SEEKERSUNG/ESP32AirCheck/3Dmodel/preview_base_top.png

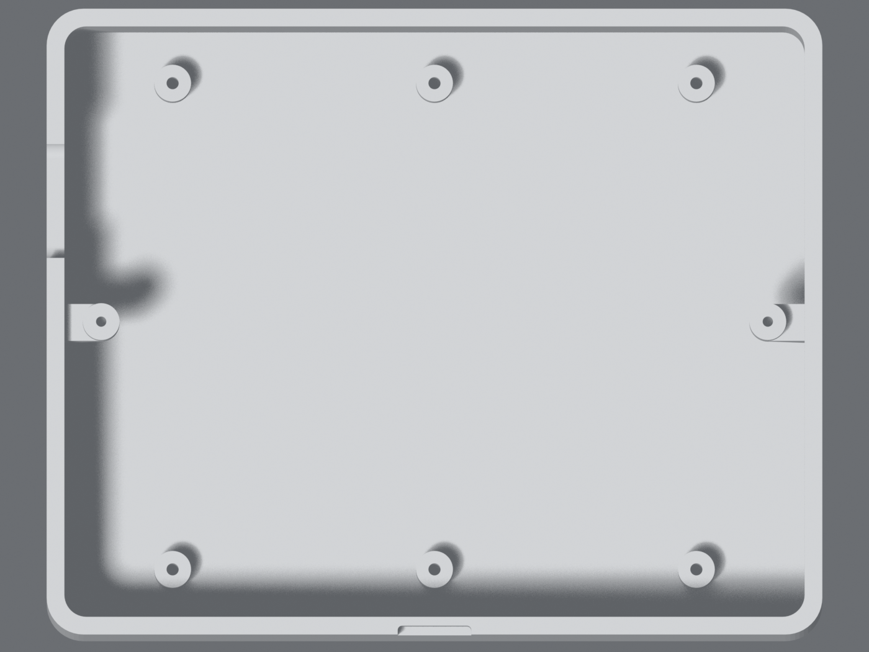
3Dmodel/preview_base_top.png
