SEEKERSUNG/ESP32AirCheck/3Dmodel/preview_exploded.png

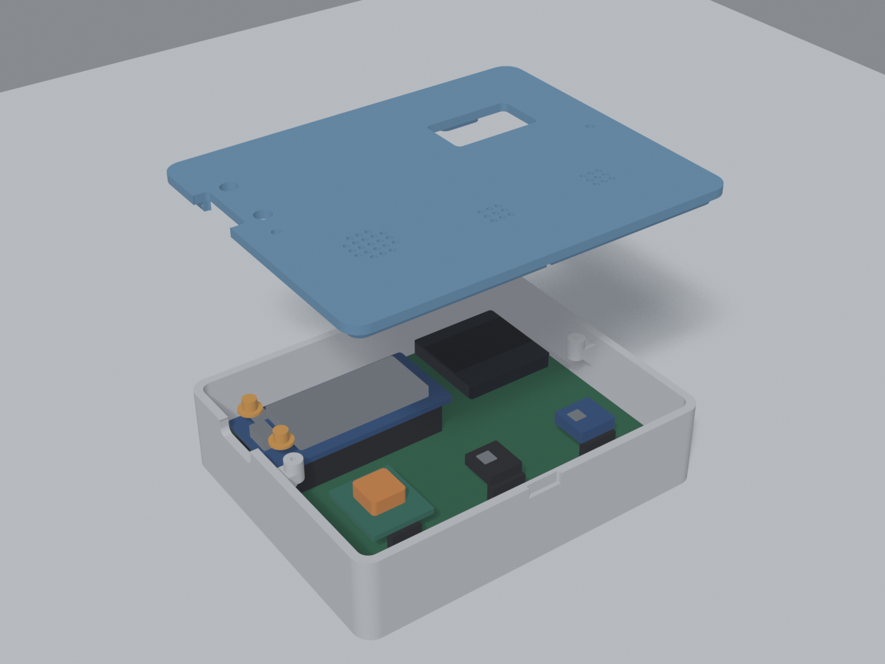
3Dmodel/preview_exploded.png
