SEEKERSUNG/ESP32AirCheck/3Dmodel/preview_lid_bottom.png

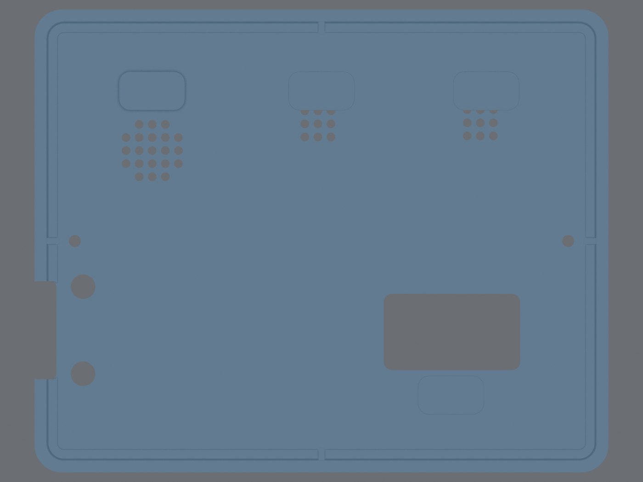
3Dmodel/preview_lid_bottom.png
