SEEKERSUNG/ESP32AirCheck/3Dmodel/preview_top.png

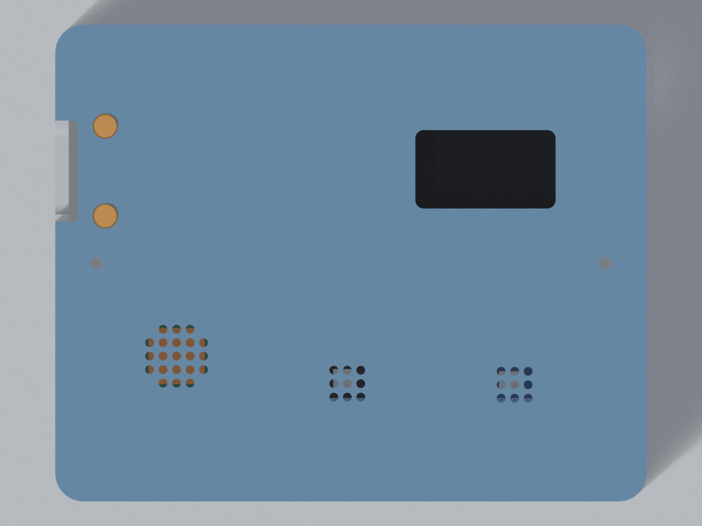
3Dmodel/preview_top.png
