SEEKERSUNG/ESP32AirCheck/tools/ui_layout.png

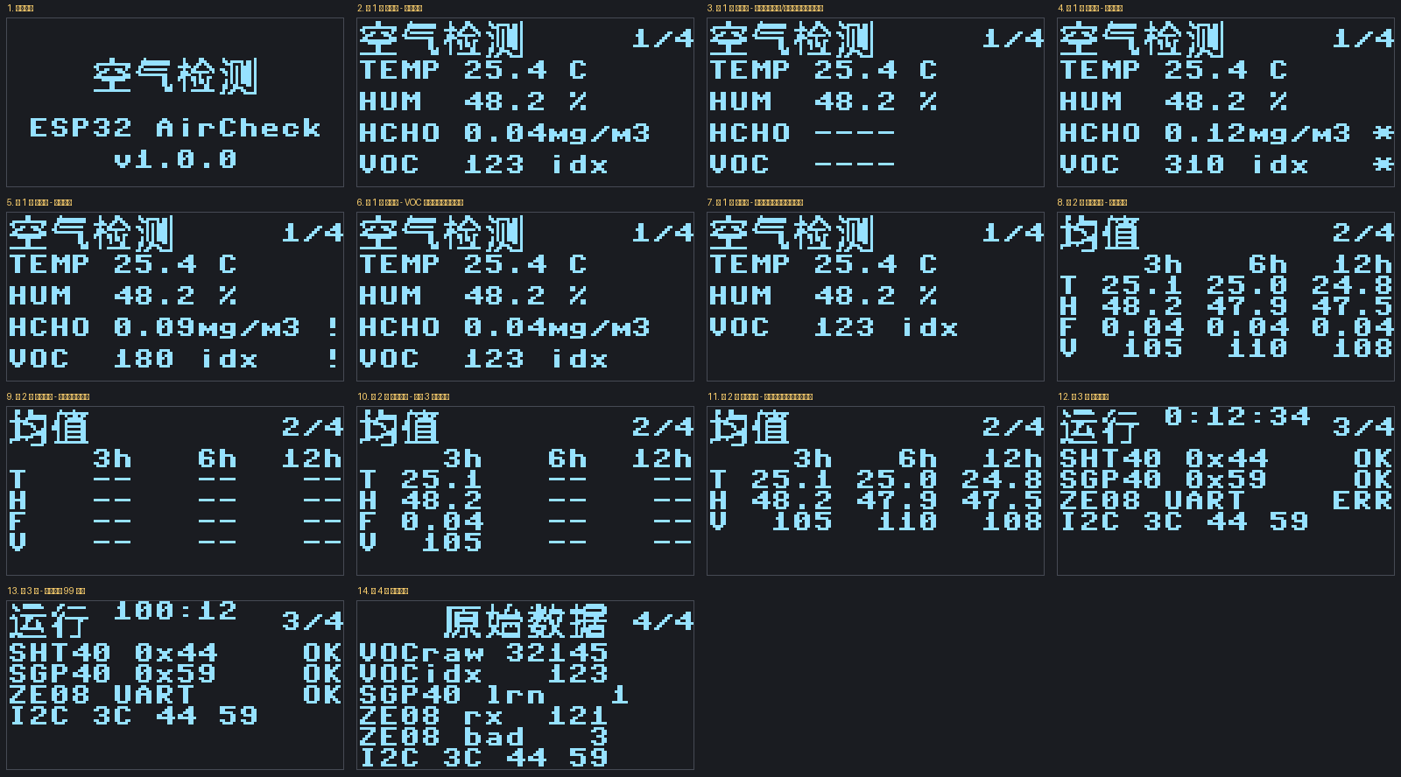
tools/ui_layout.png
