SEEKERSUNG/ESP32AirCheck/3Dmodel/ESP32AirCheck_enclosure_lid.stl

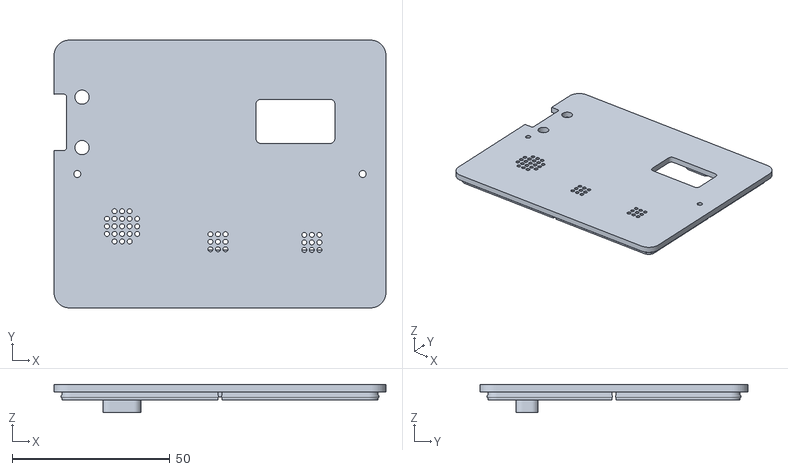
[picture p6: CAD file, 2026-11-01]
3Dmodel/ESP32AirCheck_enclosure_lid.stl
105.3 x 85.0 x 8.90
