SEEKERSUNG/ESP32AirCheck/PCB/ESP32AirCheckAllInOnePCB/3D_PCB1_2026-10-26.step

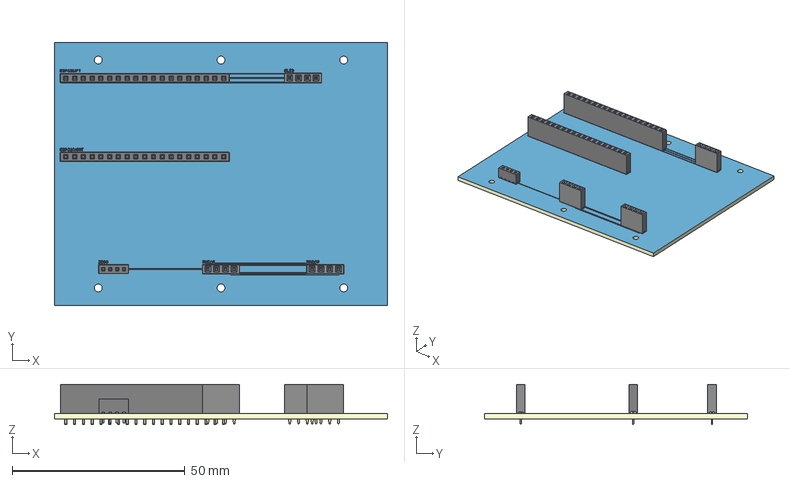
[picture p7: CAD file, 2026-11-01]
PCB/ESP32AirCheckAllInOnePCB/3D_PCB1_2026-10-26.step
96.5 x 76.2 x 11.7 mm
Board~Zxer
TopCopper~Zxer x 46
BottomCopper~Zxer x 46
TopSilkscreen~Zxer x 43
BottomSilkscreen~Zxer
TopFpcStiffener~Zxer
BottomFpcStiffener~Zxer
HDR-TH_4P-P2.00-V-F~HDR-TH_4P-P2.00-F-LI-1X4P~50VS
HDR-TH_4P-P2.54-V-F~HDR-TH_4P-P2.54-V-F~HYyp x 3
HDR-TH_19P-P2.54-V-F~HDR-TH_19P-P2.54-F-LI-1X19P~odMT x 2
