SEEKERSUNG/ESP32AirCheck/3Dmodel/ESP32AirCheck.3mf

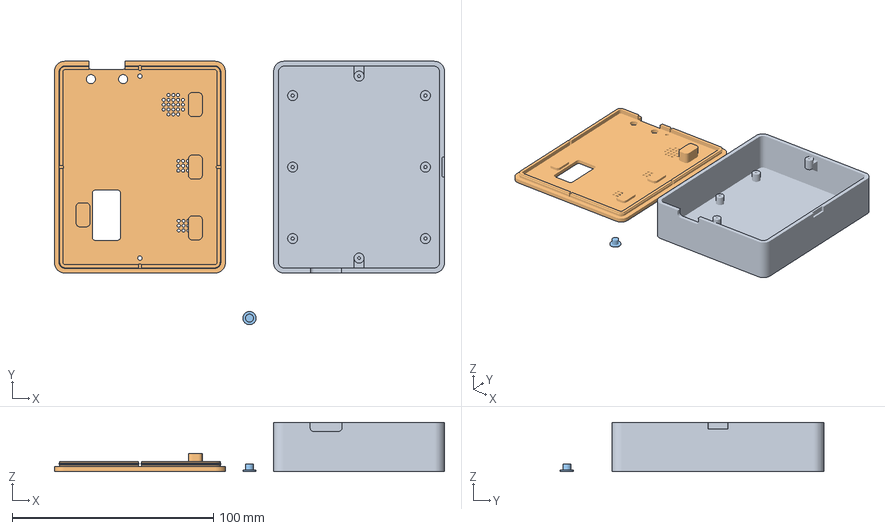
[picture p8: CAD file, 2026-11-01]
3Dmodel/ESP32AirCheck.3mf
194.0 x 131.1 x 24.4 mm
ESP32AirCheck_enclosure_base.stl
ESP32AirCheck_enclosure_lid.stl
ESP32AirCheck_button.stl
