SEEKERSUNG/ESP32AirCheck/3Dmodel/ESP32AirCheck_enclosure_base.stl

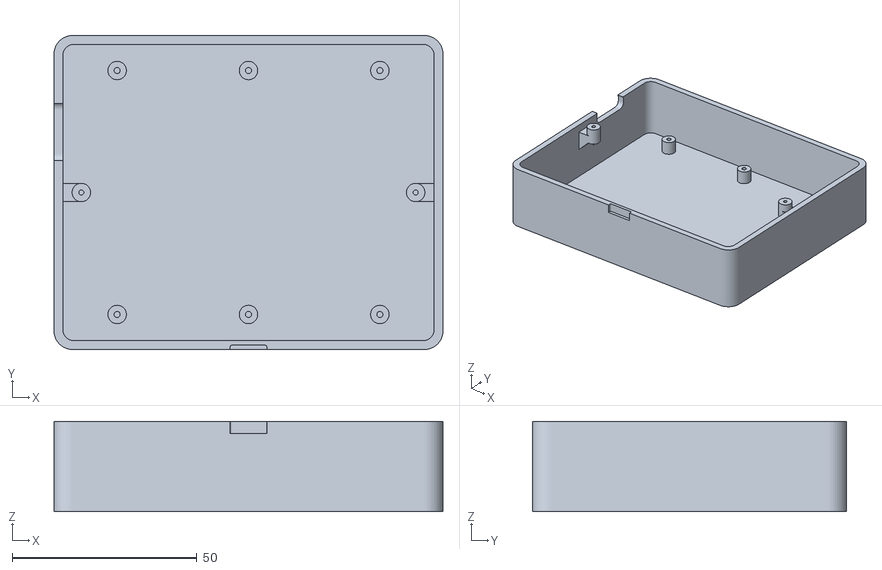
[picture p9: CAD file, 2026-11-01]
3Dmodel/ESP32AirCheck_enclosure_base.stl
105.3 x 85.0 x 24.4
