SEEKERSUNG/ESP32AirCheck/3Dmodel/ESP32AirCheck_button.stl

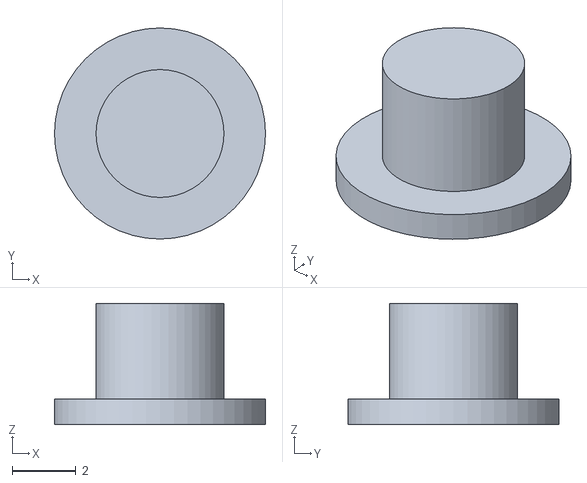
[picture p10: CAD file, 2026-11-01]
3Dmodel/ESP32AirCheck_button.stl
6.60 x 6.60 x 3.80
