SEEKERSUNG/ESP32AirCheck/(list of files, cad)

Other CAD files:
3Dmodel/ESP32AirCheck_enclosure.blend
3Dmodel/ESP32AirCheck_preview.blend
