SEEKERSUNG/ESP32AirCheck/3Dmodel/preview_assembly.png

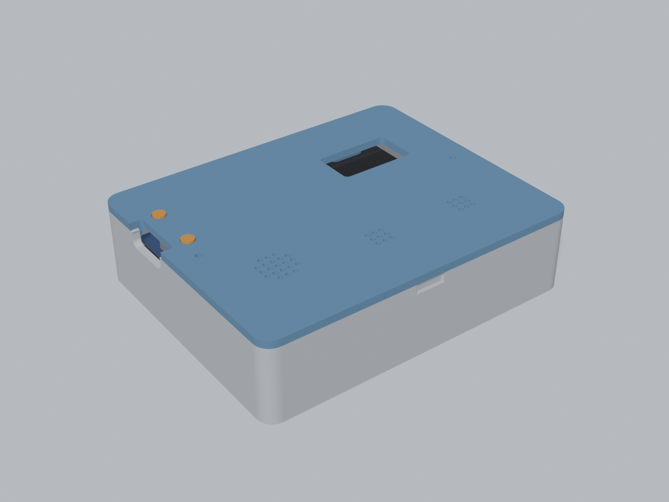
3Dmodel/preview_assembly.png
