SEEKERSUNG/ESP32AirCheck/src/config.py

# -*- coding: utf-8 -*-
"""
ESP32 空气质量检测仪 —— 全局配置
================================================================
所有需要按自己的硬件修改的内容都集中在本文件, 其它文件一般不用改。

硬件清单
    MCU      : ESP32 经典款 (ESP32-WROOM-32 / ESP32 DevKitC)
    显示屏   : 1.2 寸 OLED, 128x64, I2C (SSD1306 或 SH1106)
    温湿度   : SHT40   (I2C, 地址 0x44)
    TVOC     : SGP40   (I2C, 地址 0x59)
    甲醛     : ZE08-CH2O (UART, 9600 8N1)

接线请看项目根目录 README.md 的“接线表”。
"""

VERSION = "1.0.0"
BOARD = "ESP32-GENERIC"

# --------------------------------------------------------------------------
# 1. 调试
# --------------------------------------------------------------------------
# True  : 通过 USB 串口(REPL) 打印运行日志, 便于排查问题
# False : 安静模式, 只驱动屏幕
DEBUG = True
# 打印 I2C 扫描结果
DEBUG_SCAN = True

# --------------------------------------------------------------------------
# 2. I2C 总线
#     OLED / SHT40 / SGP40 三者共用一条 I2C 总线
#     它们的地址互不冲突, 可以并联在同一组 SDA/SCL 上
# --------------------------------------------------------------------------
I2C_ID = 0
# 本板子的排针没有引出 GPIO21, 所以 I2C 改用 GPIO32/33。
# 这两个脚不与本项目其它外设(GPIO0/2/16/17/25)冲突。
I2C_SDA = 32            # GPIO32 -> 所有 I2C 模块的 SDA
I2C_SCL = 33            # GPIO33 -> 所有 I2C 模块的 SCL
I2C_FREQ = 400000       # 400kHz 快速模式

# --------------------------------------------------------------------------
# 3. OLED 显示屏
# --------------------------------------------------------------------------
OLED_ENABLED = True

# 控制器型号:
#   "ssd1306" —— 绝大多数 0.96 寸 / 1.2 寸 128x64 模块
#   "sh1106"  —— 部分 1.3 寸 / 早期 1.2 寸 128x64 模块
# 如果屏幕点不亮, 或者整幅图像向右错位 2 个像素, 就把这里改成 "sh1106"。
# 也可以用工具脚本在线判断: python tools/deploy.py run test_oled
OLED_CONTROLLER = "ssd1306"

OLED_WIDTH = 128
OLED_HEIGHT = 64
OLED_ADDR = 0x3C        # 极少数模块是 0x3D
OLED_CONTRAST = 0xFF    # 0~255 亮度
OLED_ROTATE = False     # True 表示 180° 翻转

# 屏幕刷新周期 (毫秒)
UI_PERIOD_MS = 250

# 无操作自动息屏:
# 超过该时间没有按键操作就关闭 OLED 显示; 按 BOOT 键 (GPIO0) 唤醒。
# 唤醒的那次按键只亮屏, 不翻页; 再按才切换页面。
# 设为 0 表示关闭息屏功能。
SCREEN_OFF_MS = 10 * 1000

# --------------------------------------------------------------------------
# 4. I2C 传感器地址
# --------------------------------------------------------------------------
SHT40_ADDR = 0x44       # SHT40 默认地址, ADDR 引脚拉高则为 0x45
SGP40_ADDR = 0x59       # SGP40 固定地址

# 各传感器是否启用 (单独测试某个传感器时可以只留一个 True)
SHT40_ENABLED = True
SGP40_ENABLED = True

# --------------------------------------------------------------------------
# 5. ZE08-CH2O 甲醛传感器 (UART)
# --------------------------------------------------------------------------
ZE08_ENABLED = True
ZE08_UART_ID = 2
ZE08_TX = 17            # ESP32 的 TX (GPIO17) -> ZE08 的 RXD
ZE08_RX = 16            # ESP32 的 RX (GPIO16) <- ZE08 的 TXD
ZE08_BAUD = 9600        # 出厂固定 9600 8N1

# --------------------------------------------------------------------------
# 6. 指示灯 / 按键 / 蜂鸣器 (不需要可以关掉)
# --------------------------------------------------------------------------
STATUS_LED = 2                  # 板载蓝色 LED (ESP32 DevKitC); 无则填 None
STATUS_LED_ACTIVE_LOW = False   # 板载 LED 低电平点亮时改 True

BUTTON_ENABLED = True           # 接一个按键到 GND, 用于翻页/消音
# GPIO0 就是开发板上标着 BOOT 的那个按键, 不用额外接线。
# 注意: GPIO0 是启动模式选择脚, 上电/复位那一刻不能按住,
#       否则 ESP32 会进下载模式而不是运行程序。
BUTTON_PIN = 0                  # 内部上拉, 按下为低电平
# 长按 BOOT 键多久触发“重新学习 VOC 基线”(毫秒)
# 短按仍然是翻页/唤醒; 设为 0 关闭长按功能
VOC_RESET_HOLD_MS = 3000

BUZZER_ENABLED = False          # 有源蜂鸣器, 报警时鸣叫
BUZZER_PIN = 25


# --------------------------------------------------------------------------
# 7. 上电预热时间 (秒)
# --------------------------------------------------------------------------
# 预热的含义: 传感器已连上、也在正常通信, 但读数还没到可信状态。
# 预热期间屏幕上会显示专门的“预热中”标记和倒计时。
#
# 依据 (详见 README.md 的说明):
#   SHT40   几乎不需要预热, 上电后第一次测量即可用
#   ZE08    数据手册标明 预热时间 <= 3 分钟
#   SGP40   算法前 45s 为 blackout, 约 1 小时才完全收敛到最佳状态
#           这里取 60s 作为“可读数”的门限, 1 小时内屏幕右上角仍会显示
#           “学习”标记 (~), 表示 VOC 指数还在自我学习基线
WARMUP_SHT40 = 1
WARMUP_ZE08 = 180
WARMUP_SGP40 = 60

# SGP40 VOC 算法的完整学习时间(秒), 仅用于在屏幕上显示“学习期”标记
VOC_LEARN_S = 3600

# VOC 基线跨断电保存:
# 算法状态写入 ESP32 的 NVS (不是 SGP40 —— 传感器内部没有基线存储)。
# 上电时如果找到有效状态就恢复, 避免重新学习; 运行中每 10 分钟保存一次。
# 想彻底重新学习: 在 REPL 里执行
#     import sensors; sensors._erase_state()
# 然后复位/重启。只把 VOC_STATE_PERSIST 改成 False 只是本次不读不写,
# 旧状态还在。
VOC_STATE_PERSIST = True
VOC_STATE_SAVE_MS = 10 * 60 * 1000      # 10 分钟

# --------------------------------------------------------------------------
# 8. 历史均值 (第 2 页: 近 3 / 6 / 12 小时平均值)
# --------------------------------------------------------------------------
# 传感器是 1Hz 采样, 直接把 12 小时的原始点全存下来要几百 KB, 放不下。
# 这里每 HISTORY_BUCKET_MS 把这段时间内的采样压成一个"桶"的平均值,
# HISTORY_SLOTS 个桶围成一个环:
#   3h = 36 桶, 6h = 72 桶, 12h = 144 桶(5 分钟一个桶时刚好都是整数)
# 桶内平均对每个采样点等权, 所以结果和直接对原始点求平均一致。
# 屏幕上的均值每 5 分钟才更新一次, 这是刻意的: 均值是慢变量。
HISTORY_BUCKET_MS = 5 * 60 * 1000       # 5 分钟一个桶
HISTORY_SLOTS = 144                     # 144 桶 = 12 小时

# 跨断电保留 (写入 ESP32 NVS, 约 1.2KB)。
# 注意板子没有 RTC, 无法知道断电了多久, 恢复时按"一直在线"处理。
HISTORY_PERSIST = True
HISTORY_SAVE_MS = 10 * 60 * 1000        # 10 分钟存一次

# --------------------------------------------------------------------------
# 9. 报警阈值
# --------------------------------------------------------------------------
# WARN  = 警告级: 主界面数值旁显示常亮 !, LED/蜂鸣器不动作
# ALARM = 报警级: 主界面闪烁 *, 板载 LED 快闪, (若启用)蜂鸣器鸣叫
#
# 甲醛: 0.08 参考 GB/T 18883-2022 (1小时均值), 0.10 为项目报警线。
# 代码比较的是瞬时值, 不是 1 小时滑动平均。
HCHO_WARN = 0.08        # mg/m3
HCHO_ALARM = 0.10       # mg/m3

# VOC 指数 (Sensirion 定义): 100 为基线, 越大空气越差
# 注意这是指数, 不是浓度; 界面标签为 VOC
TVOC_WARN = 150
TVOC_ALARM = 250

# --------------------------------------------------------------------------
# 10. 采样 / 轮询周期
# --------------------------------------------------------------------------
# I2C 传感器的主轮询周期 (毫秒)
I2C_POLL_MS = 1000
# 断开/未连接传感器的重新探测周期 (毫秒) —— 支持运行中热插拔传感器
RESCAN_MS = 10000

# LED / 蜂鸣器
LED_HEARTBEAT_MS = 2000

# --------------------------------------------------------------------------
# 11. Wi-Fi / Home Assistant MQTT (可选)
# --------------------------------------------------------------------------
# 真实凭据放在 src/secrets.py (已被 .gitignore 忽略), 不要写进本文件。
# 留空则完全不启用网络, 不影响本地采集和屏幕。
try:
    from secrets import (WIFI_SSID, WIFI_PASSWORD, MQTT_HOST, MQTT_PORT,
                         MQTT_USER, MQTT_PASSWORD)
except ImportError:
    WIFI_SSID = ""
    WIFI_PASSWORD = ""
    MQTT_HOST = ""
    MQTT_PORT = 1883
    MQTT_USER = ""
    MQTT_PASSWORD = ""

MQTT_BASE = "esp32aircheck"     # 主题前缀, 后面会拼设备 MAC
MQTT_PUBLISH_MS = 10000         # 状态发布周期 (毫秒)
MQTT_KEEPALIVE = 60
HA_DISCOVERY = True             # 自动发布 Home Assistant MQTT Discovery
HA_DISCOVERY_PREFIX = "homeassistant"
DEVICE_NAME = "ESP32 AirCheck"
