SEEKERSUNG/ESP32AirCheck/src/cfont.py

# -*- coding: utf-8 -*-
# 本文件由 tools/gen_font.py 自动生成, 请勿手工修改。
# 字体来源: msyh.ttc
# 每个汉字 16x16, 32 字节, LSB-first (bit0 = 最左像素)
# 具体用哪个 framebuf 格式由 ui.py 运行时探测(MONO_GLYPH)。

GLYPH_W = 16
GLYPH_H = 16

GLYPHS = {
    0x4e2d:  # 中
    b'\x00\x00\x80\x00\x80\x00\x80\x00\xfe\x3f\xfe\x3f\x82\x20\x86\x20\x86\x30\xfe\x3f\x86\x30\x80\x00\x80\x00\x80\x00\x80\x00\x00\x00',
    0x4e60:  # 习
    b'\x00\x00\xfe\x7f\xe4\x6f\x00\x60\x38\x60\xe0\x60\x80\x61\x00\x60\x00\x6e\xc0\x67\xf8\x60\x1e\x60\x00\x60\x00\x3f\x00\x1f\x00\x00',
    0x4f20:  # 传
    b'\x00\x00\x10\x03\x18\x03\xd8\x3f\x08\x01\x8c\x01\xec\x7f\x8e\x00\xca\x3f\x08\x3f\xc8\x18\x88\x0d\x08\x07\x08\x0c\x00\x00\x00\x00',
    0x4fe1:  # 信
    b'\x00\x00\x10\x02\x18\x06\xf8\x7f\x08\x00\xcc\x3f\x0c\x00\xce\x3f\x08\x00\xc8\x3f\xc8\x3f\x48\x20\xc8\x3f\xc8\x3f\x00\x00\x00\x00',
    0x5019:  # 候
    b'\x00\x00\x98\x1f\x98\x1f\x28\x10\xec\x7f\xac\x01\x2e\x3b\xae\x3f\xa8\x04\xe8\x7f\xa8\x7f\x28\x0e\x88\x1b\xc8\x71\x00\x00\x00\x00',
    0x503c:  # 值
    b'\x00\x00\x10\x02\xf8\x7f\x48\x36\x88\x1f\xcc\x3f\x4c\x30\xce\x3f\x4e\x30\xc8\x3f\x48\x30\xc8\x3f\x48\x30\xfc\x7f\x00\x00\x00\x00',
    0x5168:  # 全
    b'\x00\x00\x80\x01\xc0\x03\x60\x06\x30\x0c\x1c\x38\xfe\x7f\xf0\x0f\x80\x01\xf8\x1f\xf8\x1f\x80\x01\x80\x01\xfc\x7f\x00\x00\x00\x00',
    0x539f:  # 原
    b'\x00\x00\x00\x00\xfc\x7f\x0c\x01\xec\x3f\x6c\x30\xec\x3f\xec\x3f\x6c\x30\xec\x3f\x4c\x0a\x6c\x1a\x36\x72\x96\x63\x00\x00\x00\x00',
    0x5668:  # 器
    b'\x00\x00\x00\x00\x7c\x3e\x44\x33\x7c\x3e\x7c\x3f\x80\x0d\xfe\x7f\x60\x06\x3e\x7c\x7c\x3e\x44\x32\x7c\x3e\x7c\x3e\x00\x00\x00\x00',
    0x5747:  # 均
    b'\x00\x00\x18\x03\x18\x03\x08\x7f\x98\x7f\xfe\x40\xd8\x43\x18\x46\x18\x64\x18\x78\x18\x7e\xf8\x63\x9e\x60\x02\x60\x00\x3e\x00\x00',
    0x59cb:  # 始
    b'\x00\x00\x08\x06\x08\x02\x08\x13\x3e\x31\xec\x3f\xec\x7f\x24\x40\xa4\x3f\xbc\x35\x98\x20\xb8\x20\xec\x3f\x86\x3f\x00\x00\x00\x00',
    0x5b66:  # 学
    b'\x00\x00\x88\x10\x98\x19\x10\x09\xfc\x3f\xfe\x7f\x06\x60\xf0\x0f\x00\x0e\x00\x03\xfe\x7f\xfe\x7f\x00\x01\x80\x01\xe0\x01\x00\x00',
    0x5c31:  # 就
    b'\x00\x00\x10\x06\x30\x1e\xfe\x36\x00\x06\xfc\x7f\xfc\x3f\xc4\x0e\xfc\x0e\xfc\x0a\x74\x0a\xd4\x4b\x96\x49\xb2\x69\xdc\x78\x00\x00',
    0x5e38:  # 常
    b'\x00\x00\x88\x31\x98\x19\xfe\x7f\xfe\x7f\xf2\x4f\xf8\x1f\x18\x18\xf8\x1f\x80\x01\xfc\x3f\x8c\x21\x84\x21\x84\x3d\x84\x19\x00\x00',
    0x5ea6:  # 度
    b'\x00\x00\x00\x01\xf8\x7f\xfc\x7f\x4c\x08\xfc\x7f\x4c\x08\xcc\x0f\x4c\x08\xfc\x1f\xcc\x18\x8c\x0f\x84\x07\xf6\x7c\x00\x00\x00\x00',
    0x5f02:  # 异
    b'\x00\x00\xfc\x1f\x0c\x18\x0c\x18\xfc\x5f\x0c\x60\xf8\x7f\xf8\x3f\x20\x0c\x30\x0c\xfe\x7f\x30\x0c\x18\x0c\x0c\x0c\x00\x00\x00\x00',
    0x606f:  # 息
    b'\x00\x00\xc0\x00\xf8\x1f\x18\x18\xf8\x1f\xf8\x1f\xf8\x1f\xd8\x1b\xf8\x1f\xf8\x1f\x94\x31\x34\x69\x36\x4c\xf2\x07\x00\x00\x00\x00',
    0x611f:  # 感
    b'\x00\x00\x00\x16\xf0\x3f\xfc\x7f\xec\x07\xfc\x35\xec\x1d\xb4\x4d\xf4\x6d\xf6\x3e\x86\x01\x3c\x3d\x36\x6c\xe2\x47\x00\x00\x00\x00',
    0x636e:  # 据
    b'\x00\x00\x88\x3f\xc8\x7f\x7e\x60\xfe\x7f\xc8\x3f\x48\x0c\xf8\x7f\x5e\x04\x48\x3f\xe8\x3f\xe8\x21\xa8\x3f\xbe\x3f\x00\x00\x00\x00',
    0x63a5:  # 接
    b'\x00\x00\x08\x06\xc8\x3f\xdc\x7f\xbe\x11\x08\x19\xe8\x7f\x18\x02\xfe\x7f\xc8\x7f\x88\x19\x08\x0f\x08\x1f\xee\x71\x00\x00\x00\x00',
    0x6570:  # 数
    b'\x00\x00\x30\x04\xb4\x04\xf0\x3e\xfe\x7e\x78\x23\xfc\x33\xb6\x36\x18\x16\xfe\x1c\xcc\x0c\x7c\x1c\x70\x36\xde\x63\x00\x00\x00\x00',
    0x65f6:  # 时
    b'\x00\x00\x00\x18\x3e\x18\x3e\x10\xe2\x7f\xa2\x7f\x22\x10\xbe\x19\x36\x19\x22\x1b\x22\x1a\x22\x18\x3e\x10\x26\x18\x22\x1f\x00\x00',
    0x672a:  # 未
    b'\x00\x00\x80\x01\x80\x01\xfc\x3f\xfc\x3f\x80\x01\x80\x01\xfe\x7f\xc0\x03\xe0\x07\xb0\x0d\x98\x39\x8e\x71\x80\x01\x00\x00\x00\x00',
    0x672c:  # 本
    b'\x00\x00\x80\x01\x80\x01\xfe\x7f\xfc\x7f\xc0\x03\xe0\x07\xa0\x05\xb0\x0d\x98\x19\xac\x75\xf6\x6f\x80\x01\x80\x01\x00\x00\x00\x00',
    0x6807:  # 标
    b'\x00\x00\x08\x00\x88\x3f\x3e\x00\x3e\x00\x08\x00\xdc\x7f\x3c\x04\x8e\x14\x8a\x34\xc8\x24\x68\x64\x68\x64\x88\x07\x00\x00\x00\x00',
    0x68c0:  # 检
    b'\x00\x00\x08\x06\x08\x0e\x18\x1b\xbe\x31\xc8\x60\xdc\x5f\x3c\x02\xce\x32\xca\x16\x88\x16\x88\x18\x08\x18\xc8\x7f\x00\x00\x00\x00',
    0x6c14:  # 气
    b'\x00\x00\x10\x00\xf8\x3f\xf8\x3f\x0c\x00\xf4\x1f\x06\x00\xfc\x1f\x00\x18\x00\x18\x00\x18\x00\x58\x00\x70\x00\x70\x00\x00\x00\x00',
    0x6d4b:  # 测
    b'\x00\x00\x04\x40\xec\x5b\x38\x5a\xa0\x5e\xa6\x5e\xac\x5e\xa8\x5e\xa0\x5e\xa8\x5e\xa8\x5e\xcc\x58\xcc\x43\x64\x46\x36\x7c\x00\x00',
    0x6e29:  # 温
    b'\x00\x00\xc4\x1f\xcc\x3f\x48\x30\xc0\x3f\x46\x30\xcc\x3f\x40\x00\xe0\x3f\xec\x3f\x2c\x25\x2c\x25\xe4\x3d\xf6\x7f\x00\x00\x00\x00',
    0x6e7f:  # 湿
    b'\x00\x00\xc4\x3f\xec\x3f\x48\x30\xe0\x3f\x66\x20\xec\x3f\x40\x2d\x20\x4d\x6c\x6d\xec\x3d\xcc\x1d\x84\x0d\xf6\x7f\x00\x00\x00\x00',
    0x70ed:  # 热
    b'\x00\x00\x08\x03\x08\x03\xfe\x1f\x18\x1b\x18\x19\xfc\x19\x9e\x5b\x88\x5f\xc8\x70\x6e\x70\x00\x10\x2c\x32\x64\x26\x46\x66\x00\x00',
    0x7248:  # 版
    b'\x00\x00\x34\x38\xb4\x3f\xb4\x00\xb4\x00\xfc\x3f\x84\x23\x84\x22\xbc\x36\xb4\x14\xb4\x1c\xb4\x0c\xf6\x3e\xf6\x63\x00\x00\x00\x00',
    0x7532:  # 甲
    b'\x00\x00\xfe\x3f\x86\x30\x82\x20\x86\x30\xfe\x3f\x86\x30\x82\x20\x86\x30\xfe\x3f\xc6\x31\x80\x00\x80\x00\x80\x00\x80\x00\x00\x00',
    0x79d2:  # 秒
    b'\x00\x00\x30\x04\x3e\x04\x18\x15\x98\x35\xbe\x65\x98\x44\xdc\x04\x7c\x24\x1e\x34\x1a\x18\x1a\x0e\x98\x03\xd8\x01\x00\x00\x00\x00',
    0x7a0d:  # 稍
    b'\x00\x00\x80\x04\xfe\x64\x98\x35\x18\x1d\xfe\x7f\xd8\x60\x98\x7f\xbc\x7f\xfc\x60\x9e\x7f\x9a\x7e\x98\x60\x98\x3c\x00\x00\x00\x00',
    0x7a7a:  # 空
    b'\x00\x00\x80\x01\x80\x01\xfc\x7f\x06\x60\x64\x2e\x38\x1c\x0c\x70\xfe\x7f\xf0\x1f\x80\x01\x80\x01\x80\x01\xfe\x7f\x00\x00\x00\x00',
    0x7eea:  # 绪
    b'\x00\x00\x18\x02\x08\x22\x8c\x3f\x24\x12\x36\x1a\xde\x7f\x08\x06\x0c\x3f\xfe\x3f\xfe\x21\x80\x3f\xb8\x31\xbe\x3f\x80\x3f\x00\x00',
    0x81ea:  # 自
    b'\x00\x00\xc0\x00\xc0\x00\xfc\x3f\x0c\x30\x04\x20\xfc\x3f\xfc\x3f\x04\x20\x0c\x30\xfc\x3f\x0c\x30\x04\x20\xfc\x3f\xfc\x3f\x00\x00',
    0x884c:  # 行
    b'\x00\x00\x30\x00\x98\x3f\x08\x00\x26\x00\x36\x00\xd8\x7f\x18\x18\x1c\x08\x1e\x08\x18\x08\x18\x08\x18\x08\x18\x0f\x00\x00\x00\x00',
    0x8bf7:  # 请
    b'\x00\x00\x00\x06\xec\x7f\x58\x06\xc0\x3f\x00\x06\xee\x7f\x8c\x1d\xc8\x3f\x48\x30\xc8\x3f\xc8\x30\xf8\x3f\x5c\x30\x4c\x3c\x00\x00',
    0x8d85:  # 超
    b'\x00\x00\x10\x3f\x90\x3f\x7e\x22\x10\x22\x10\x3f\xfe\x01\x30\x3f\x34\x33\x74\x21\x34\x3f\x3e\x3f\x3e\x01\xf2\x7f\x00\x00\x00\x00',
    0x8fd0:  # 运
    b'\x00\x00\xc4\x1f\xcc\x3f\x18\x00\x00\x00\xe4\x7f\x8e\x03\x88\x09\x88\x18\xc8\x18\xe8\x3f\x08\x20\x3e\x00\xf6\x7f\x00\x00\x00\x00',
    0x8fde:  # 连
    b'\x00\x00\x04\x01\x8c\x07\xf8\x7f\x80\x04\xc0\x06\xce\x06\xc8\x3f\x08\x04\xe8\x7f\xe8\x7f\x0c\x06\x1e\x04\xf6\x7f\x00\x00\x00\x00',
    0x90e8:  # 部
    b'\x00\x00\x30\x00\x30\x7e\xfe\x67\x8c\x26\xc8\x36\x78\x16\xfe\x37\x00\x66\xfc\x66\xfc\x46\x84\x46\x84\x7e\xfc\x16\xfc\x06\x00\x00',
    0x919b:  # 醛
    b'\x00\x00\x7e\x32\xfe\x7f\x38\x3f\x7e\x0c\x7e\x1e\xfe\x33\xfe\x7f\x66\x0c\x46\x0c\x7e\x3f\x42\x0c\x7e\x0c\xfe\x7f\x00\x00\x00\x00',
    0x95f4:  # 间
    b'\x00\x00\x04\x00\xcc\x3f\x18\x20\x02\x20\xf2\x27\x32\x26\x32\x26\xf2\x27\x32\x26\x32\x26\xf2\x27\xf2\x21\x02\x20\x02\x3c\x00\x00',
    0x9875:  # 页
    b'\x00\x00\xfe\x7f\x80\x01\x80\x01\xf8\x3f\x08\x30\x88\x31\x88\x31\x88\x31\x88\x31\x88\x33\xc0\x0f\x70\x3c\x3e\x70\x00\x00\x00\x00',
    0x9884:  # 预
    b'\x00\x00\xfe\x7f\x30\x04\x1c\x04\x98\x3f\xbe\x25\xfe\x2d\xe8\x2d\xb8\x2d\x98\x25\x98\x25\x18\x0e\x18\x3b\xce\x61\x00\x00\x00\x00',
}
