SEEKERSUNG/ESP32AirCheck/(commit log)

2026-10-17 新增 ESP32 空气质量检测仪 (SHT40/SGP40/SCD40/ZE08 + OLED)
    硬件: ESP32 经典款 + 1.2 寸 OLED(128x64) + SHT40 温湿度 + SGP40 TVOC + SCD40 CO2 + ZE08-CH2O 甲醛
    - src/ asyncio 主程序、四路传感器驱动、Sensirion VOC 指数算法移植、16x16 中文字库、SSD1306/SH1106 驱动
    - 上电逐个自检 + 预热倒计时标记 + 热插拔定时重探测 + I2C 总线卡死自恢复
    - tools/ 部署脚本、字库生成、界面排版预览、板上测试、主机回归测试
    - README 接线表(I2C=GPIO32/33, ZE08=GPIO16/17)、报警阈值、常见问题、开发笔记
    - .gitignore 忽略 __pycache__
    [boot.py, cfont.py, config.py, main.py, sensors.py]
2026-10-20 移除 CO2/SCD40 支持, 直接进主界面, 按键改 GPIO0
    - 彻底移除 SCD40 二氧化碳支持: 删 src/scd40.py 和 tools/tests/test_scd40.py,
    以及 config 里的 SCD40_ADDR/SCD40_ENABLED/WARMUP_SCD40/CO2_WARN/CO2_ALARM/
    SCD40_EVERY, 状态机里的 scd40 通道与 co2 字段, 界面里的 CO2 行和第 4 个状态灯
    - 删除开机自检页: 上电直接进主界面, 未连接/异常的传感器在状态栏内联提示,
    其余传感器照常显示数值
    - 修复三处只在真机上才暴露的 bug:
    * I2C 通道初值 ST_PROBE 不在探测分支里, 导致永远不探测
    * any_alarm() 依赖 snapshot() 求值, 没有屏幕时报警不生效
    * learning 对所有通道为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
    [cfont.py, config.py, framebuf.py, machine.py, main.py, sensors.py]
2026-10-20 更新文档: 与移除 CO2 后的实际代码对齐
    - 第 3 页示例里的 I2C 扫描结果去掉 0x62
    - 开机画面时长改成实测的 1.2 秒 (原写 2 秒)
    - 主界面说明补上"关闭的传感器整行不画、剩余行自动上收"
    - 5.5 说明字库是按 gen_font.py 顶部的 CHARS 生成的, 缺字会画空心方框
    - 5.4 补充 run_board_test.py 的适用范围 (test_ui.py 必须上板跑)
    - 新增常见问题: 串口打不开的两种 PermissionError (被占用 vs CH340 卡死)
    - 新增开发笔记 10.9: 一个 enabled 有三个消费者, 必须同时判断
    - 10.2 行距说明按现在的三行数据 + 状态栏宽度限制重写
    - 10.6 的症状描述改成"状态栏停在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
2026-10-20 新增息屏与 VOC 基线持久化, 修复总线恢复等问题
    - 主界面只显示读数, 连接/预热状态统一看第 2 页
    - VOC 基线每 10 分钟存入 ESP32 NVS, 断电重启后恢复
    - 10 秒无操作自动熄屏, 按 BOOT 键唤醒且不翻页
    - 修复总线恢复失败后不再重试、SH1106 无法旋转等问题
    - 补充 NVS、息屏、排版回归测试并同步文档
    [config.py, main.py, sensors.py, sh1106.py, test_state_machine.py, test_ui.py]
2026-10-21 修正传感器换算与显示, 支持 ZE08 问答模式
    - ZE08 问答模式周期请求, 修复 5 秒后掉线
    - 统一 ze08.ugm3 单位为 ug/m3, 超量程限幅
    - HCHO 显示改为 2 位小数, 主界面标签改为 VOC
    - 启用警告阈值: 警告 ! / 报警 *; 修正 SGP40 软复位和 SHT40 加热器
    - 补充 ZE08 问答、单位、警告阈值回归测试并同步文档
    [config.py, sensors.py, sgp40.py, sht40.py, test_state_machine.py, test_ui.py, test_ze08_parse.py, ui.py]
2026-10-21 文档: 补充 ZE08 探测阶段问答命令重试说明
2026-10-24 新增长按 BOOT 重置 VOC 基线
    - 长按 BOOT 3 秒清除算法状态和 NVS 基线, 以当前环境重新学习
    - 短按改为松手触发, 长按释放不翻页
    - 补充长按/短按和重置逻辑回归测试, 更新文档
2026-10-24 新增 Home Assistant MQTT 接入
    - 新增 net.py: Wi-Fi/MQTT 重连、HA MQTT Discovery、状态和可用性发布
    - config/secrets.py 分离 Wi-Fi 与 MQTT 凭据, secrets.py 不入库
    - 新增 MQTT Discovery 回归测试和 README 接入说明
2026-10-25 增加PCB设计
2026-11-01 新增 3D 打印外壳与 PCB 3D 模型
    底板: 6 个 PCB 支撑柱 (M2 自攻), 左壁充电口开到接缝, 撬盖槽
    顶盖: OLED 窗口, 3 组传感器网孔, 4 个按压凸台, 2 颗 M2 螺丝孔, 2 个按钮孔
    按钮: 独立打印件 2 个, 底盘卡在壳内
    附图 5 张预览与参数化生成脚本
    [3D_PCB1_2026-10-26.step, ESP32AirCheck.3mf, ESP32AirCheck_button.stl, ESP32AirCheck_enclosure.blend, ESP32AirCheck_enclosure_base.stl, ESP32AirCheck_enclosure_lid.stl, ESP32AirCheck_preview.blend]
2026-11-01 文档: 外壳 README 增加介绍章节与文件树, 补充 3mf 说明
2026-11-01 文档: 根 README 增加 3D 外壳章节与目录树
2026-11-02 新增第 2 页历史均值: 近 3/6/12 小时平均值
    - history.py: 5 分钟一个采样桶, 144 桶构成 12 小时环; 3h/6h/12h
    分别取最近 36/72/144 桶, 桶内平均对 1Hz 采样等权
    - 只统计预热完成的通道, 数值按 int16 放大存储 (共 1152 字节)
    - 每 10 分钟写入 NVS (aircheck/histstate), 上电恢复; 无 RTC 时按
    连续在线处理
    - ui.py: 新增均值页并调整为第 2 页, 运行信息/原始数据顺延为第 3/4 页
    - cfont: 补充 均 / 值 两个字
    - 测试: test_history.py(PC) + test_history_state.py(板) + 状态机第 10 节
    - README: 页面说明、7.9 采样频率、config 速查、目录树同步更新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
